freeDSP/freeDSP-CLASSIC-SMD-A/(commit log)

2016-02-23 - offline Version 0.1 - tested - status update in README.md
    [FreeDSP_SMD.kicad_pcb, FreeDSP_SMD.sch]
2016-03-26 - PLL filter now referenced to +3V3
    [FreeDSP_SMD.kicad_pcb, FreeDSP_SMD.sch]
2016-05-17 - added pullup for WP Pin
    [FreeDSP_SMD.kicad_pcb, FreeDSP_SMD.sch]
2016-05-17 - fixed mirrored stereo jack
    [FreeDSP_SMD.kicad_pcb, FreeDSP_SMD.sch]
2016-06-10 - added selectable LRCLK and BCK bridges for pseudo master mode on inputs - added GERBER folder - added labels
    [FreeDSP_SMD.kicad_pcb, FreeDSP_SMD.sch]
2017-10-10 - fixed missspelled label
    [FreeDSP_SMD.kicad_pcb]
2017-10-10 + added GERBER folder + WP jumper for EEPROM flashing ~ I2C pullups reduced to 1k5 (400khz selfboot needs faster risetimes) ~ Reset pullup reduced to 4k7 (DAC board has 10k pulldown onboard) ~ increm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
    [FreeDSP_SMD.kicad_pcb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]
2018-02-04 - did a cosmetic update where the stereo jacks were mirrored in the footprint as well as on the board. so nothing changed except that the jacks are now correctly displayed as being on the same layer 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
    [FreeDSP_SMD.kicad_pcb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]
2018-02-05 - reduced via diameter to something more reasonable - transferred text to silkscreen - optimized some more GND plane issues
    [FreeDSP_SMD.kicad_pcb]
2018-02-05 - preparation for Release V1.1
    [FreeDSP_SMD-B.Cu.gbr, FreeDSP_SMD-B.Mask.gbr, FreeDSP_SMD-B.SilkS.gbr, FreeDSP_SMD-Edge.Cuts.gbr, FreeDSP_SMD-F.Cu.gbr, FreeDSP_SMD-F.Mask.gbr, FreeDSP_SMD-F.SilkS.gbr, FreeDSP_SMD-NPTH.drl]
2018-02-05 - increased the Version number to 1.2 - removed gerber files
    [FreeDSP_SMD-B.Cu.gbr, FreeDSP_SMD-B.Mask.gbr, FreeDSP_SMD-B.SilkS.gbr, FreeDSP_SMD-Edge.Cuts.gbr, FreeDSP_SMD-F.Cu.gbr, FreeDSP_SMD-F.Mask.gbr, FreeDSP_SMD-F.SilkS.gbr, FreeDSP_SMD-NPTH.drl]
2018-03-10 - one more ground plane fix - base commit for V1.2
    [FreeDSP_SMD.kicad_pcb]
2018-09-11 - migrated to KiCAD 5
    [FreeDSP_SMD.kicad_pcb, FreeDSP_SMD.sch]
2019-07-12 - fixed a missing track
    [FreeDSP_SMD.kicad_pcb, FreeDSP_SMD.sch]
